robdobsn/Door-Opener/CAD/Outputs/Main Shaft Locker.3mf

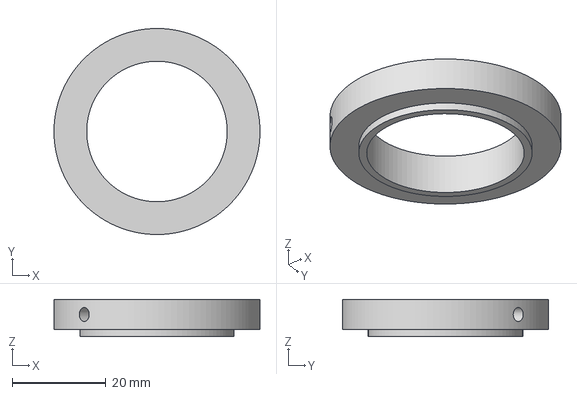
[picture p1: CAD file, 2025-12-06]
CAD/Outputs/Main Shaft Locker.3mf
44.0 x 44.0 x 8.00 mm
