robdobsn/Door-Opener/CAD/Outputs/PIR Holder Lid.3mf

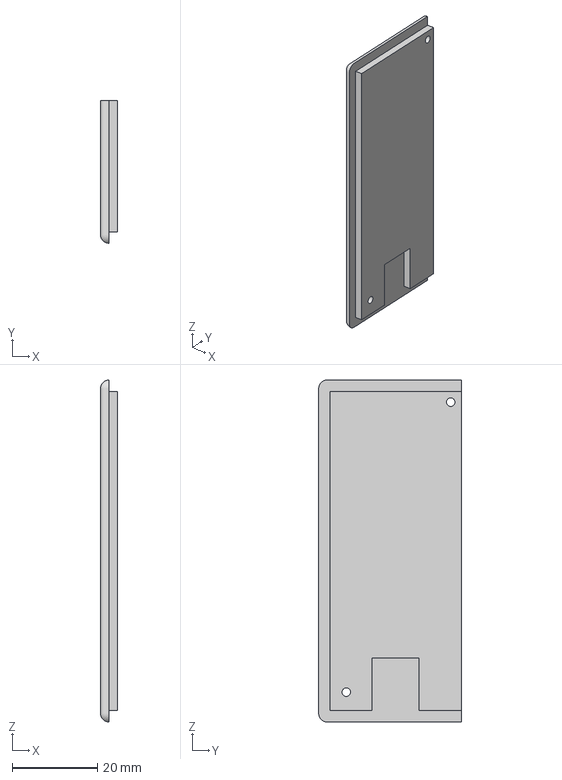
[picture p2: CAD file, 2025-12-06]
CAD/Outputs/PIR Holder Lid.3mf
4.00 x 33.5 x 80.2 mm
