robdobsn/Door-Opener/CAD/Outputs/Left Plate Laser Cut.dxf

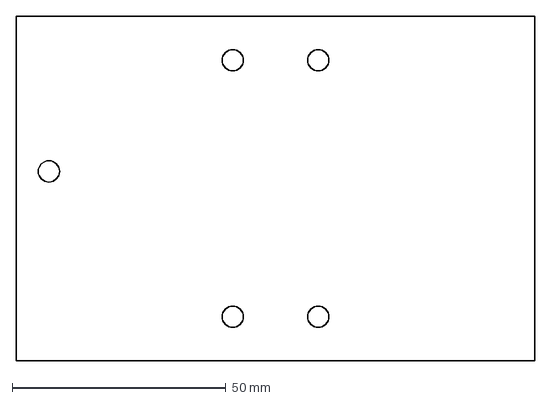
[picture p3: CAD file, 2025-12-06]
CAD/Outputs/Left Plate Laser Cut.dxf
121.2 x 80.6 mm
