robdobsn/Door-Opener/CAD/Outputs/Bearing Mount.3mf

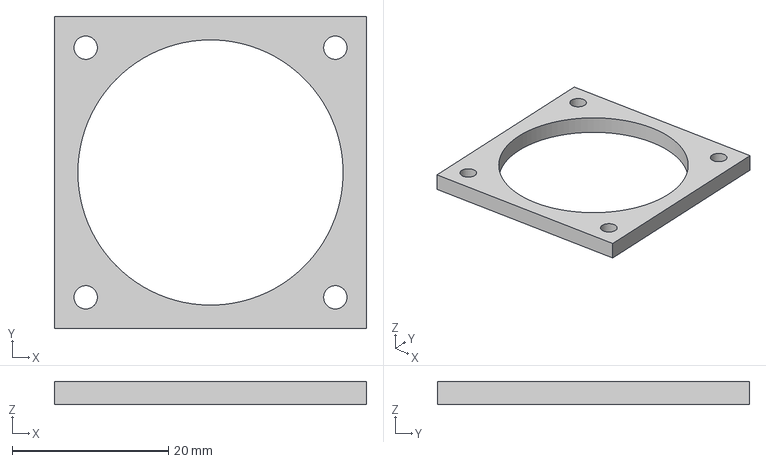
[picture p4: CAD file, 2025-12-06]
CAD/Outputs/Bearing Mount.3mf
40.0 x 40.0 x 3.00 mm
