robdobsn/Door-Opener/CAD/Outputs/Lever Tip.3mf

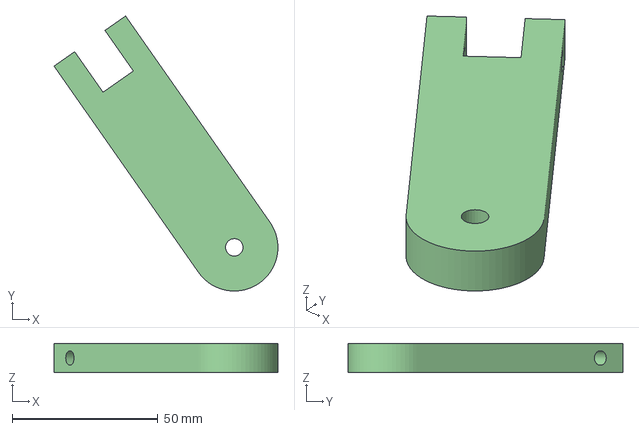
[picture p5: CAD file, 2025-12-06]
CAD/Outputs/Lever Tip.3mf
76.9 x 94.4 x 10.00 mm
