robdobsn/Door-Opener/CAD/Outputs/Lower Plate Laser Cut.dxf

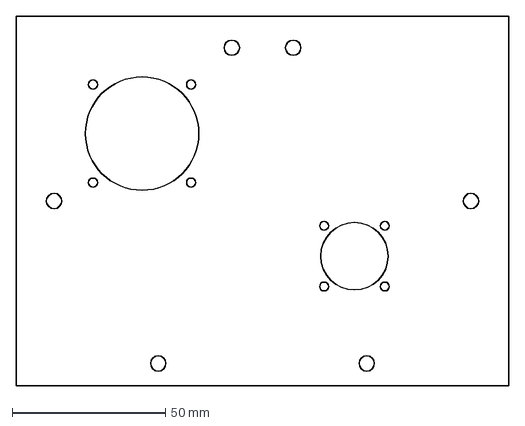
[picture p6: CAD file, 2025-12-06]
CAD/Outputs/Lower Plate Laser Cut.dxf
160.6 x 120.6 mm
