robdobsn/Door-Opener/CAD/Outputs/PIR Holder.3mf

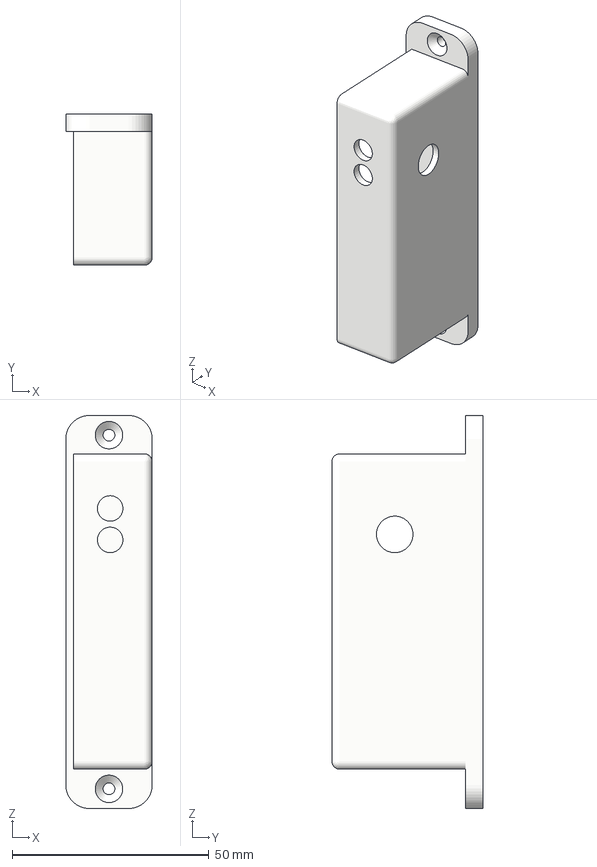
[picture p7: CAD file, 2025-12-06]
CAD/Outputs/PIR Holder.3mf
22.0 x 38.5 x 100.0 mm
