robdobsn/Door-Opener/CAD/Outputs/Button Holder Lid.3mf

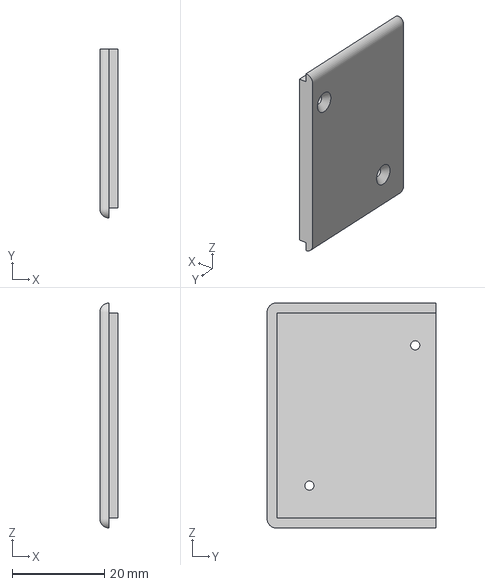
[picture p8: CAD file, 2025-12-06]
CAD/Outputs/Button Holder Lid.3mf
4.00 x 36.7 x 48.9 mm
