robdobsn/Door-Opener/CAD/Outputs/Right Plate Laser Cut.dxf

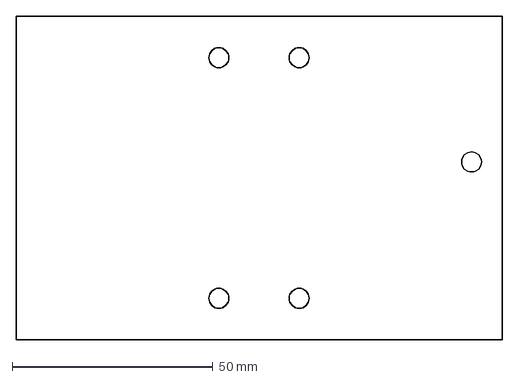
[picture p9: CAD file, 2025-12-06]
CAD/Outputs/Right Plate Laser Cut.dxf
121.2 x 80.6 mm
