robdobsn/Door-Opener/CAD/Outputs/Button Holder.3mf

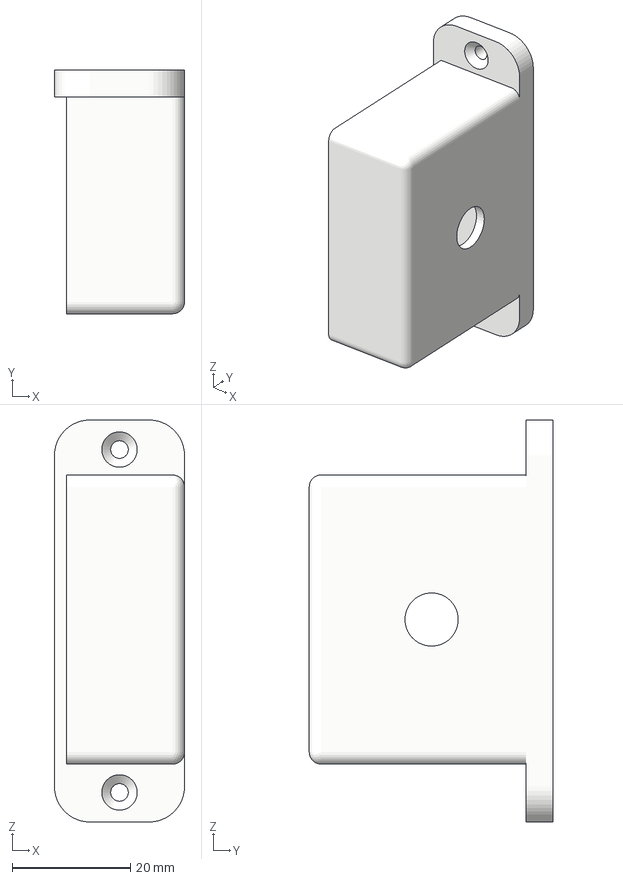
[picture p10: CAD file, 2025-12-06]
CAD/Outputs/Button Holder.3mf
22.0 x 41.2 x 68.0 mm
