robdobsn/Door-Opener/CAD/Outputs/Motor Pinion.3mf

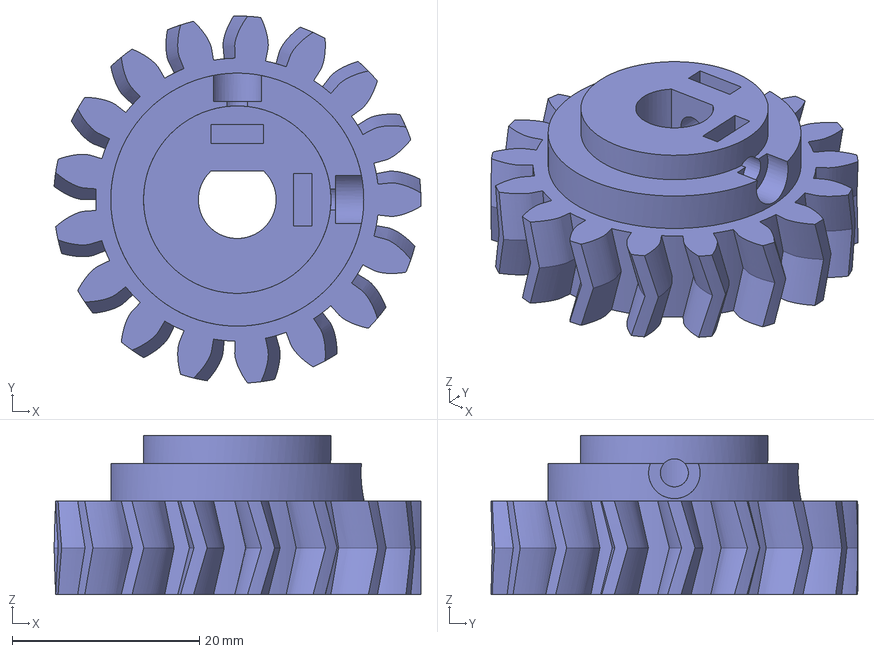
[picture p11: CAD file, 2025-12-06]
CAD/Outputs/Motor Pinion.3mf
39.1 x 39.2 x 17.0 mm
