robdobsn/Door-Opener/CAD/Outputs/Door Push Laser Cut.dxf

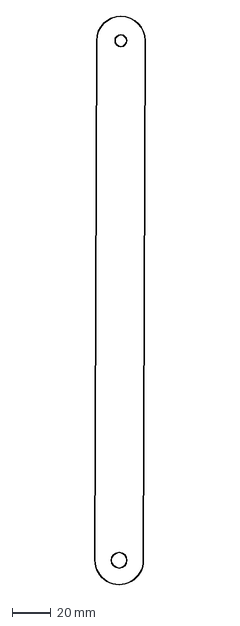
[picture p12: CAD file, 2025-12-06]
CAD/Outputs/Door Push Laser Cut.dxf
25.9 x 292.5 mm
