robdobsn/Door-Opener/CAD/Outputs/M5Stack UI Holder.3mf

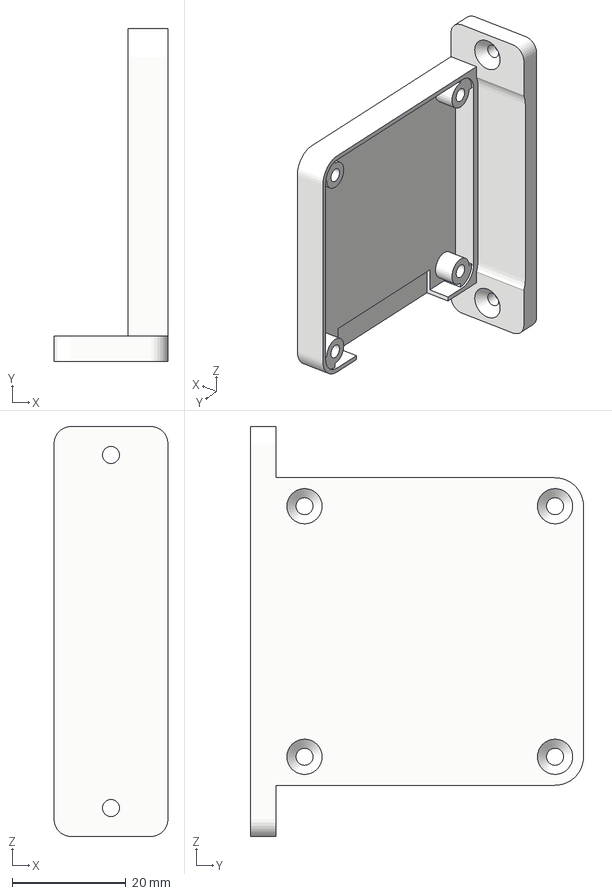
[picture p13: CAD file, 2025-12-06]
CAD/Outputs/M5Stack UI Holder.3mf
20.0 x 58.5 x 72.0 mm
