robdobsn/Door-Opener/CAD/Outputs/Geared Lever.3mf

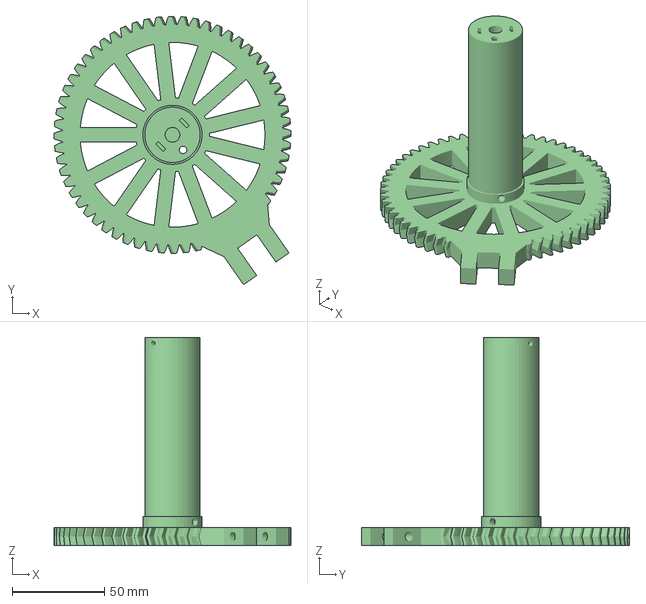
[picture p14: CAD file, 2025-12-06]
CAD/Outputs/Geared Lever.3mf
128.2 x 145.2 x 112.8 mm
