robdobsn/Door-Opener/CAD/Outputs/Door Bracket.3mf

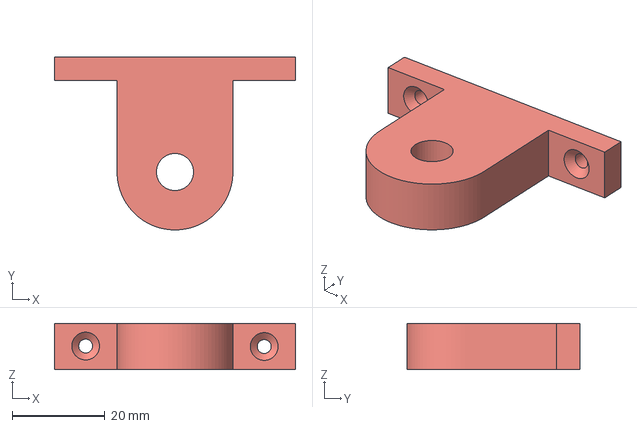
[picture p15: CAD file, 2025-12-06]
CAD/Outputs/Door Bracket.3mf
52.0 x 37.3 x 10.0 mm
