robdobsn/Door-Opener/CAD/Outputs/PIR Baffle.3mf

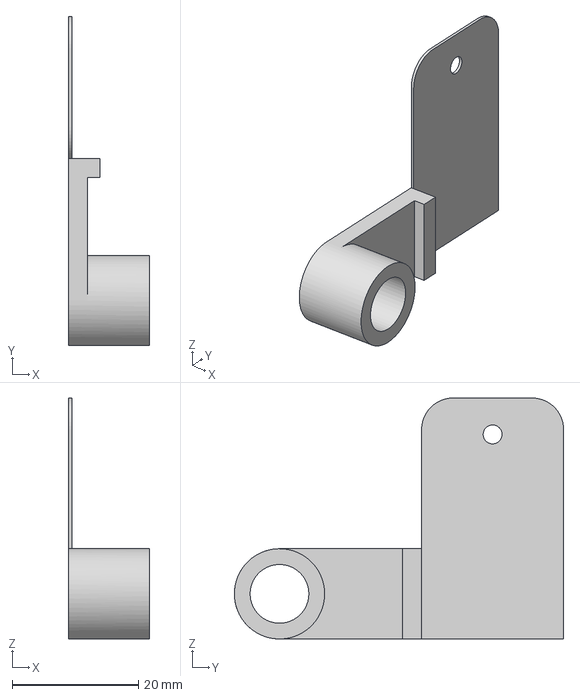
[picture p16: CAD file, 2025-12-06]
CAD/Outputs/PIR Baffle.3mf
12.8 x 52.1 x 38.2 mm
