robdobsn/Door-Opener/CAD/Outputs/Mount Plate Laser Cut.dxf

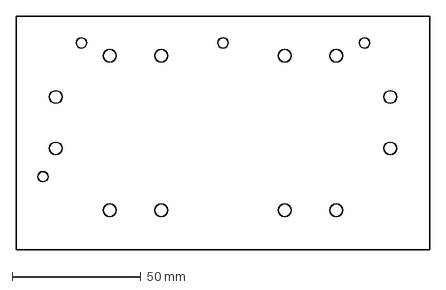
[picture p17: CAD file, 2025-12-06]
CAD/Outputs/Mount Plate Laser Cut.dxf
160.6 x 90.6 mm
