robdobsn/Door-Opener/CAD/Outputs/Upper Plate Laser Cut.dxf

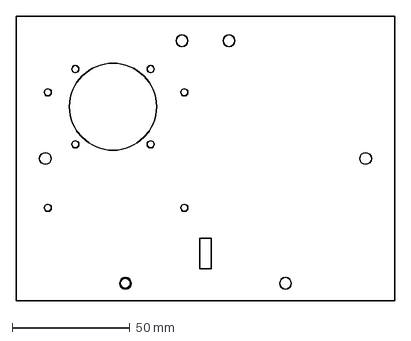
[picture p18: CAD file, 2025-12-06]
CAD/Outputs/Upper Plate Laser Cut.dxf
160.6 x 120.6 mm
