robdobsn/Door-Opener/(list of files, cad)

Other CAD files:
CAD/Door Opener Mechanism.f3z
CAD/Exit Button Holder v2.f3d
CAD/M5Stack UI Holder v3.f3d
CAD/PIR Holder v8.f3d
