robdobsn/Door-Opener/(list of files, drawings)

Other design files:
PCB/PCB_Conservatory-Opener-PCB_2025-12-06.json
PCB/SCH_Door-Opener-3.1_2025-12-06.json
